Screase3D/Voron0-AutoLoader/STL/Main Plate.stl

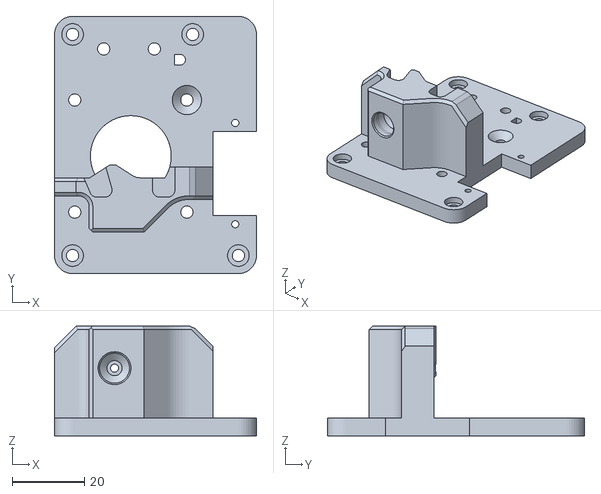
[picture p11: CAD file, 2026-10-29]
STL/Main Plate.stl
55.9 x 71.1 x 30.4
