Screase3D/Voron0-AutoLoader/CAD/V0_Backplate_Filamentloader_Inlet_Middle.step

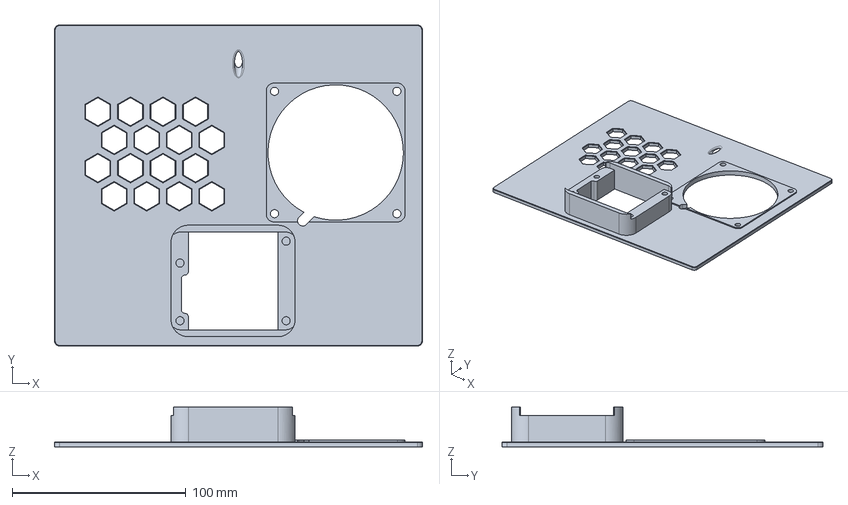
[picture p12: CAD file, 2026-10-31]
CAD/V0_Backplate_Filamentloader_Inlet_Middle.step
212.0 x 185.0 x 23.0 mm
