Screase3D/Voron0-AutoLoader/STL/Bearing Horn Adapter.stl

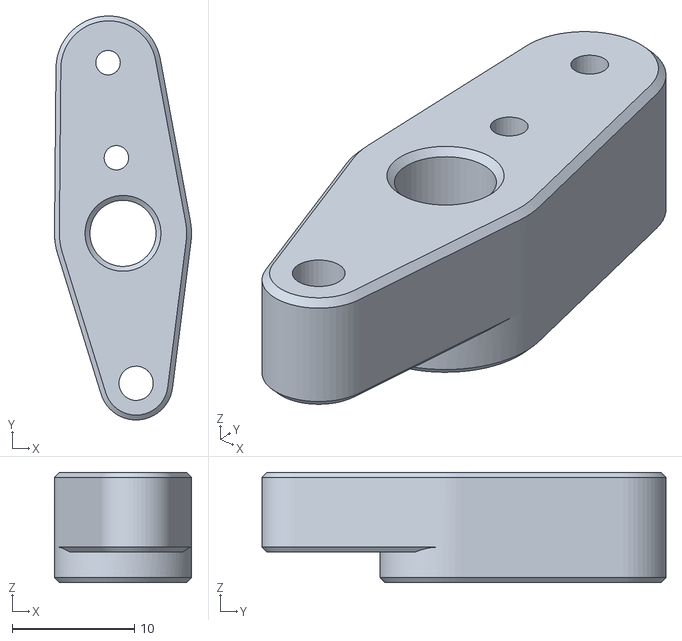
[picture p13: CAD file, 2026-10-29]
STL/Bearing Horn Adapter.stl
11.2 x 33.0 x 9.00
