Screase3D/Voron0-AutoLoader/CAD/Filament Feeder.step

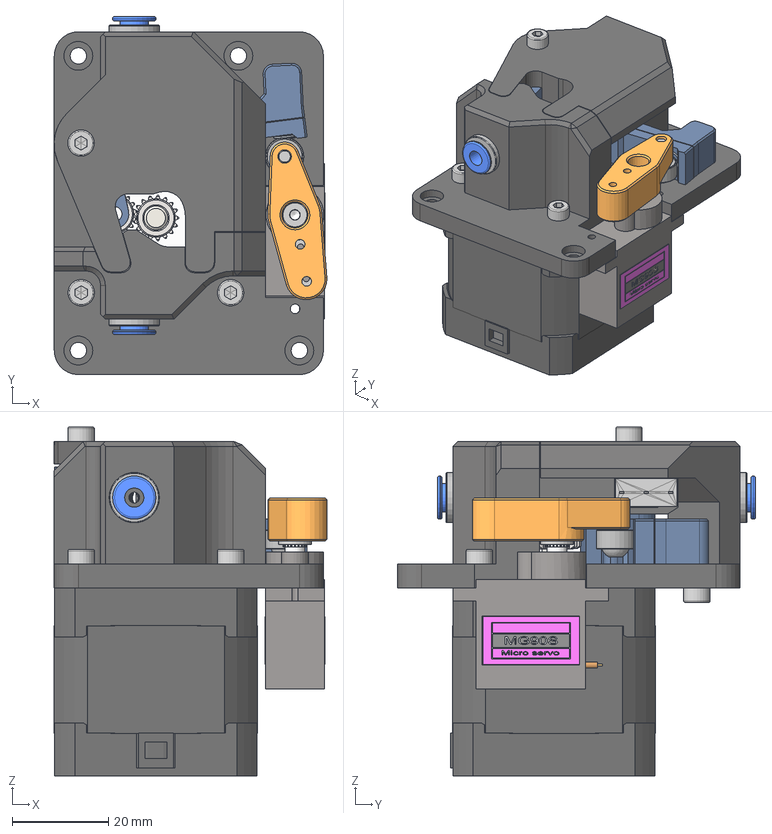
[picture p14: CAD file, 2026-10-29]
CAD/Filament Feeder.step
56.6 x 74.3 x 72.4 mm
Main Plate
Bowden In Bearing
Lever Spring V3
Lever Spring Flap V3
Servo Horn
Bearing Horn Adapter
0.4x5x15L10
ECAS04 v1
ECAS04 v1 (1)
BMG Gear Idler
BMG Gear Stepper
axe
base001
etiquette
Tube
Cylindre
Tube001
Tube002
etiquette001
Cylindre001
Cylindre002
Omron-D2F-5
693ZZ Outer Ring x 3
693ZZ Inner Ring x 3
693ZZ Shield1 x 3
693ZZ Ball x 27
693ZZ Shield2 x 3
693ZZ Outer Ring_1
693ZZ Inner Ring_1
693ZZ Shield1_1
693ZZ Ball_1 x 9
693ZZ Shield2_1
DIN EN ISO 10642 - M3 x 8 Stahl 8.8 Einfach
DIN 912 - M3 x 0.5 x 5 Stahl 4.6 Einfach x 5
ISO 4762 - M3 x 30 Stahl 4.6 Einfach
ISO 4762 - M2 x 6 Stahl 4.6 Einfach
ISO 7380-1 - M3 x 10 Stahl 4.6 Einfach
