Screase3D/Voron0-AutoLoader/STL/Bowden In Bearing.stl

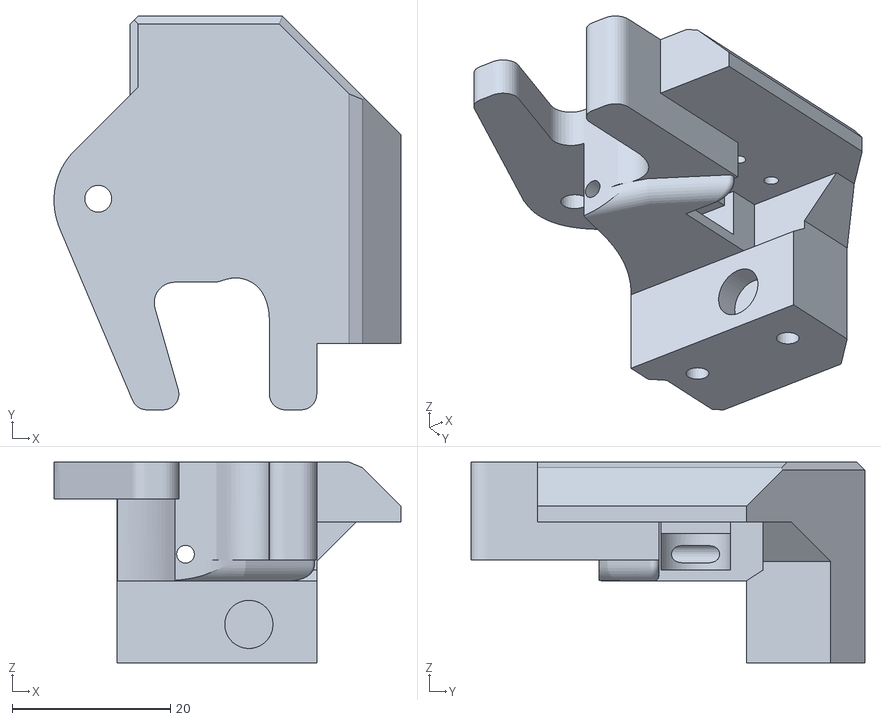
[picture p15: CAD file, 2026-10-29]
STL/Bowden In Bearing.stl
43.9 x 49.8 x 25.4
