Screase3D/Voron0-AutoLoader/STL/Lever Spring.stl

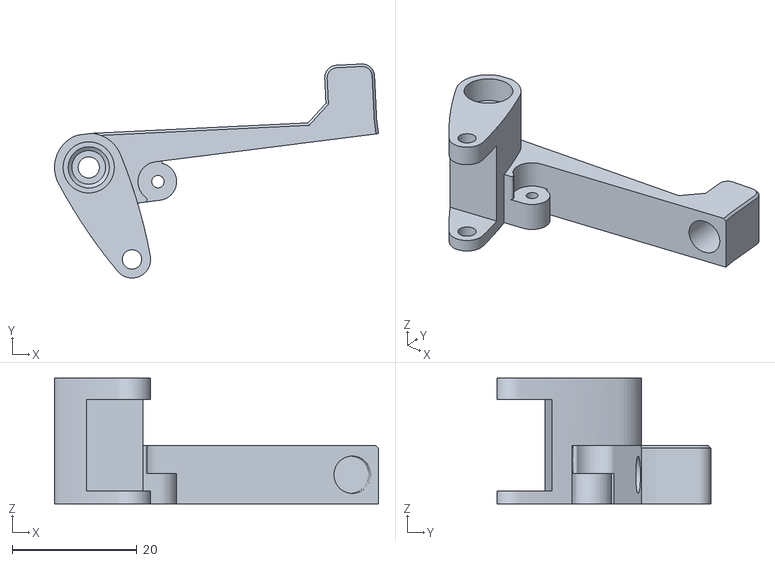
[picture p16: CAD file, 2026-10-29]
STL/Lever Spring.stl
51.9 x 34.3 x 20.1
