Screase3D/Voron0-AutoLoader/STL/Lever Spring Flap.stl

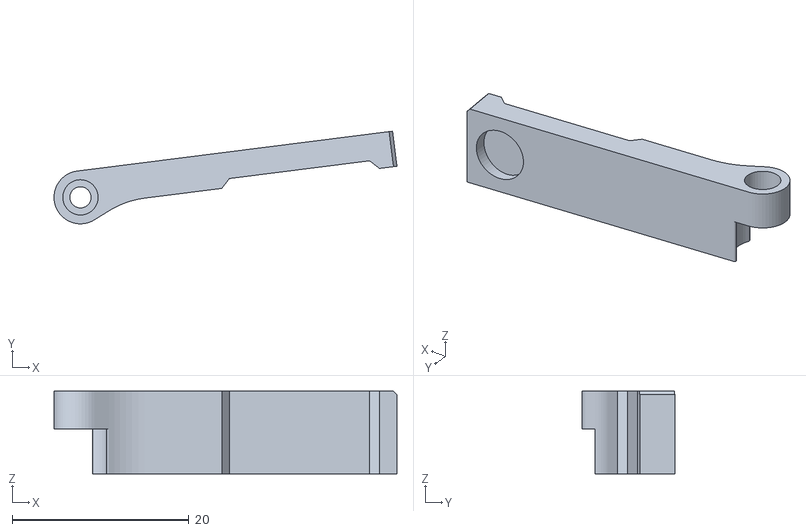
[picture p17: CAD file, 2026-10-29]
STL/Lever Spring Flap.stl
38.8 x 10.5 x 9.35
