Screase3D/Voron0-AutoLoader/(list of files, cad)

Other CAD files:
CAD/V0_Backplate_Filamentloader_Inlet_Left.step
STL/V0_Backplate_Filamentloader_Inlet_Left.stl
STL/V0_Backplate_Filamentloader_Inlet_Middle.stl
