Screase3D/Voron0-AutoLoader/docs/assembly.md

# Assembly guide

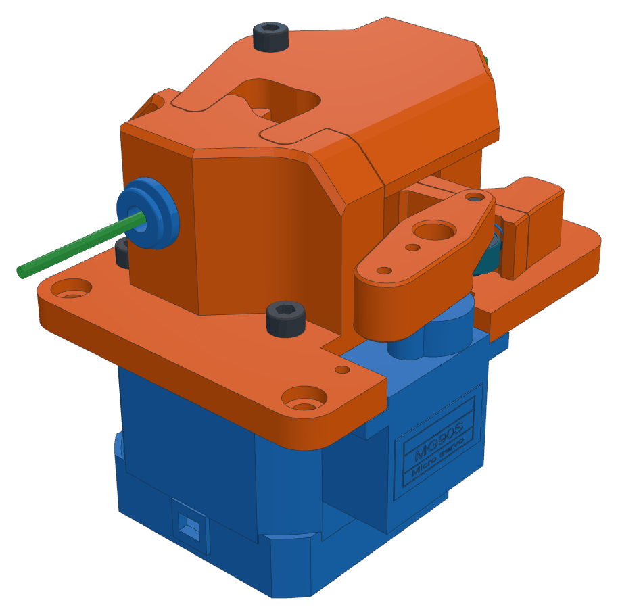
[picture p18: docs/images/assembly/overview.png]
Assembled loader
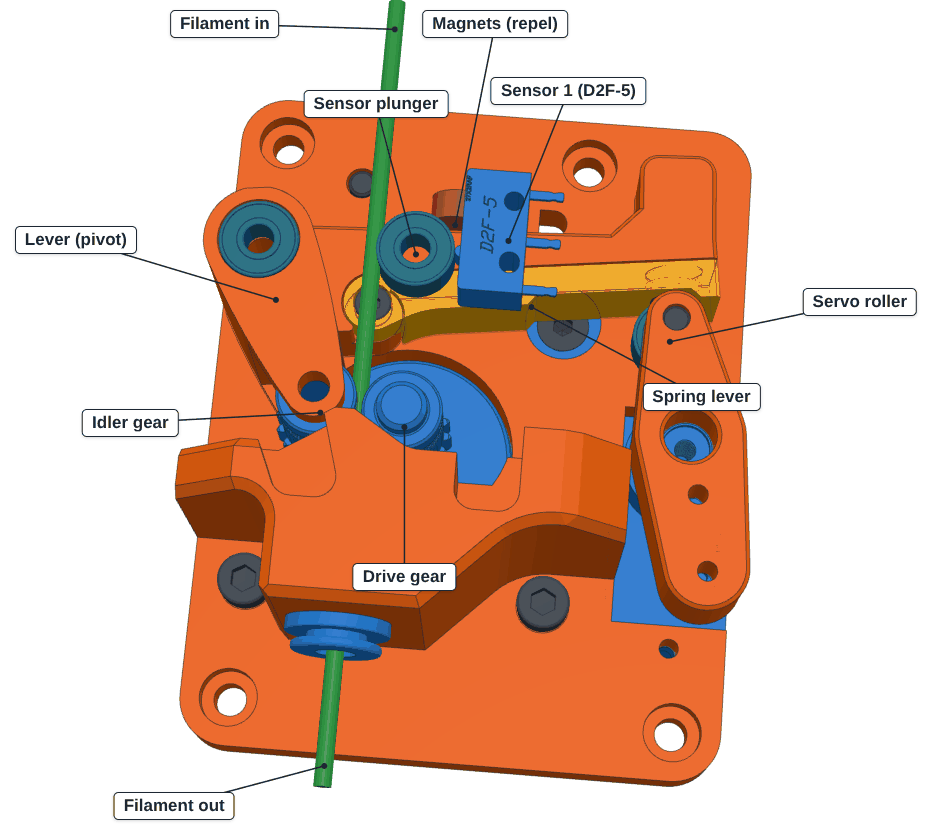
[picture p19: docs/images/assembly/function.png]
Mechanism


Orange = printed, blue = hardware, dark = screw, teal = bearing, grey = already mounted.

## Parts

**Printed** ([STL](../STL)): Main Plate, Bowden In Bearing (housing), Lever Spring (lever), Lever Spring Flap
(spring lever), Bearing Horn Adapter

| Qty | Hardware | Qty | Screws |
|---|---|---|---|
| 1 | NEMA17 stepper | 1 | M3×35 SHCS |
| 1 | MG90S servo | 2 | M3×8 SHCS |
| 1 | BMG gear set + Ø3×20 shaft | 1 | M3×8 countersunk |
| 4 | 693ZZ bearing | 2 | M3×10 SHCS |
| 1 | Omron D2F-5 | 1 | M3×10 button head |
| 2 | ECAS04 | 1 | M2×6 SHCS |
| 1 | spring 0.4×5.5×17 | 2 | M2×10 self-tapping |
| 2 | neodymium magnet 6×3 | | |
| 1 | PTFE tube 4mm OD 3mm ID | | |
| 1 | M3 Washer (for servo bearing) | | |

**Optional:** Hardware for V0.2 Backplate (see files)

| Qty | Hardware |
|---|---|
| 8 | M3x4x5mm heatset insert |
| 4 | M3x10mm SHCS |
| 4 | M3x18mm SHCS |
| 1 | Fan 80x80x10mm |

## Steps

**1.** ECAS04 into the main plate.

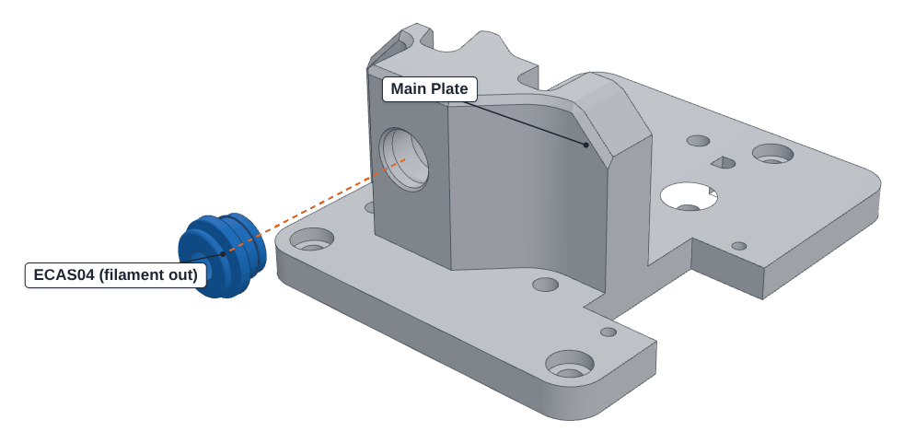
[picture p20: docs/images/assembly/01-output-coupling.png]
Step 1


**2.** Motor: 2× M3×8, 1× M3×8 countersunk. Leave the fourth hole free (pivot).

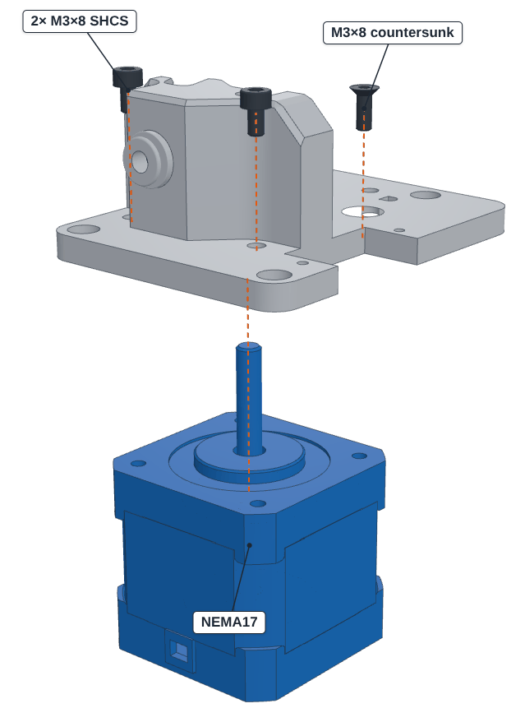
[picture p21: docs/images/assembly/02-motor.png]
Step 2


**3.** Drive gear: groove at filament height, grub screw with threadlocker.

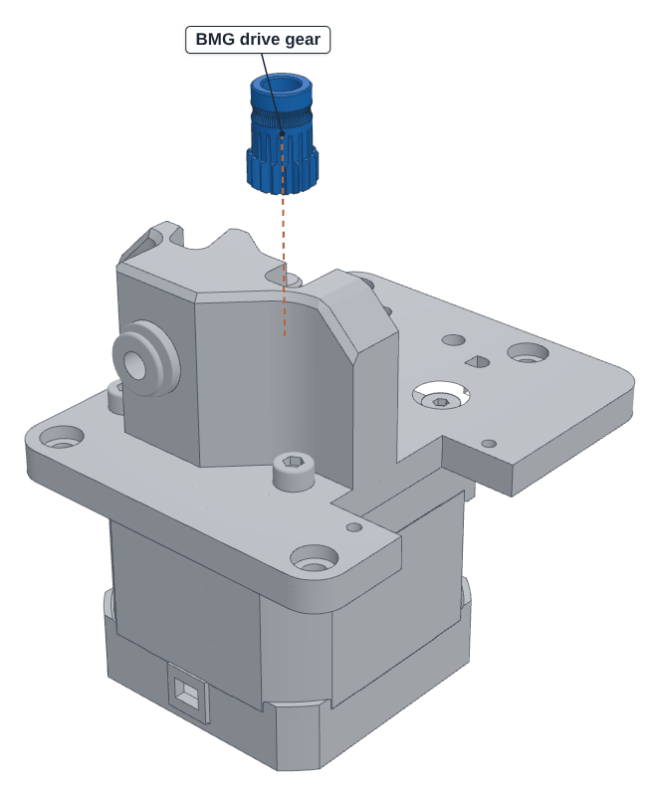
[picture p22: docs/images/assembly/03-drive-gear.png]
Step 3


**4.** Servo from below, with its two screws.

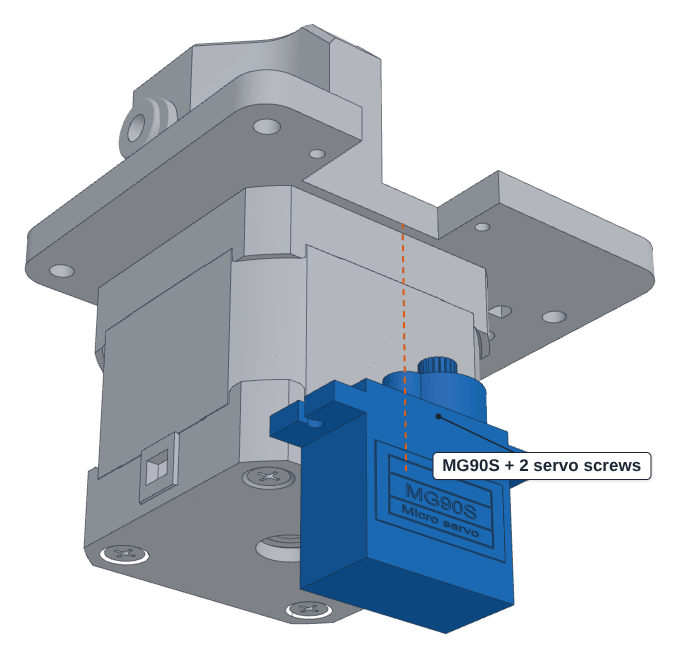
[picture p23: docs/images/assembly/04-servo.png]
Step 4


**5.** Lever: 2× 693ZZ, idler gear + shaft, spring, spring lever with M2×6 (must swing freely), magnet into the back.

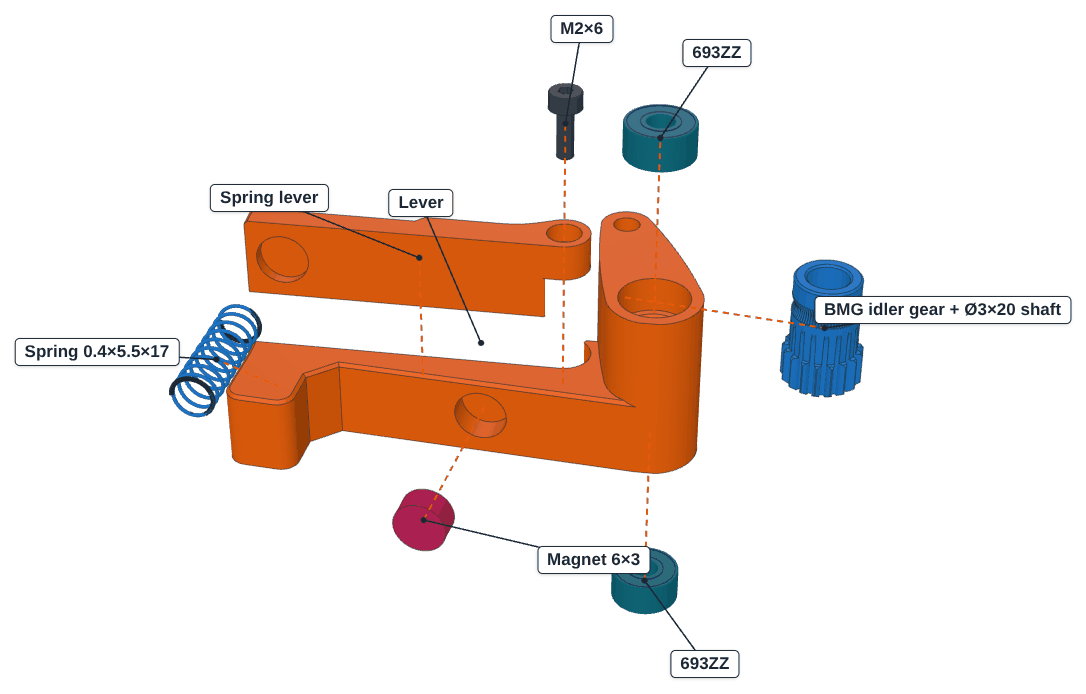
[picture p24: docs/images/assembly/05-lever.png]
Step 5


**6.** Lever onto the plate. The D-shaped hole is for the switch wires (step 8).

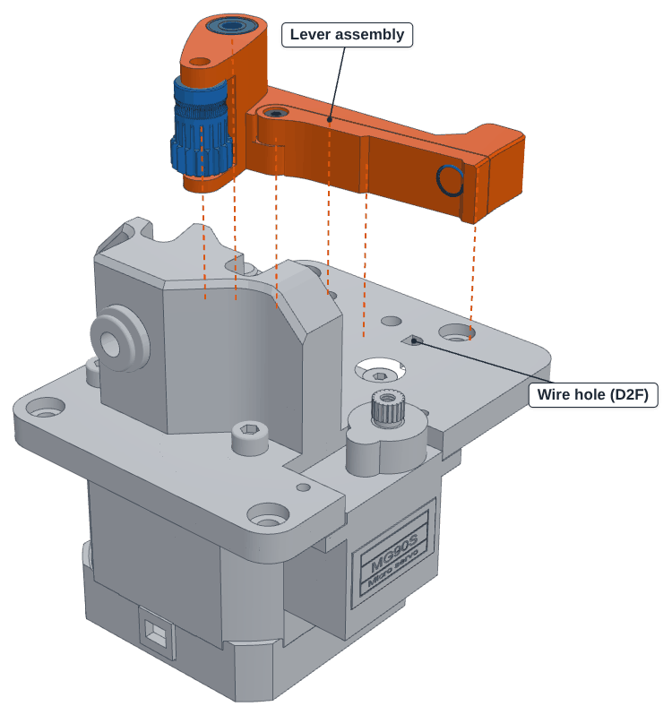
[picture p25: docs/images/assembly/06-lever-on-plate.png]
Step 6


**7.** Housing: 693ZZ into the slot, D2F-5 (wired COM + NC) with 2× M2×10 self-tapping, ECAS04, magnet.
The two magnets must **repel** each other (same pole facing): they push the lever open when the servo releases.

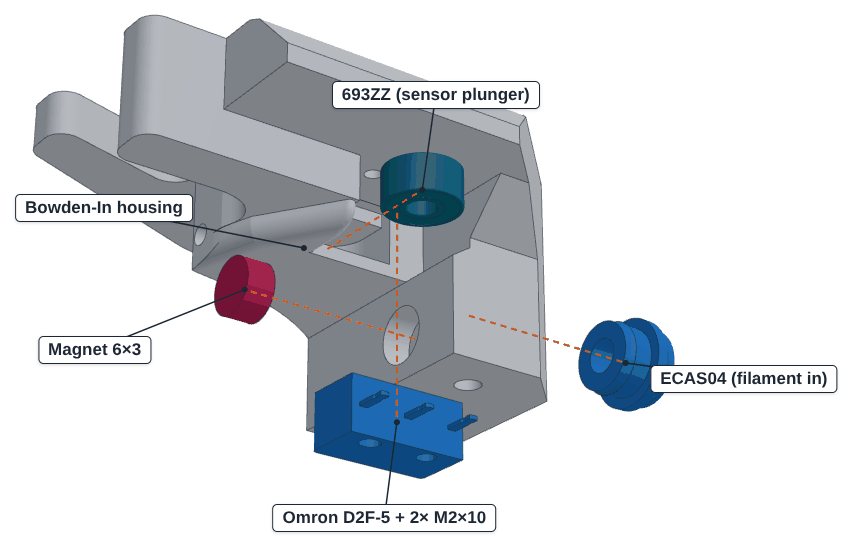
[picture p26: docs/images/assembly/07-sensor.png]
Step 7


**8.** Switch wires down through the D-shaped hole, housing on top: M3×35 through everything into the motor, 2× M3×10 from below.

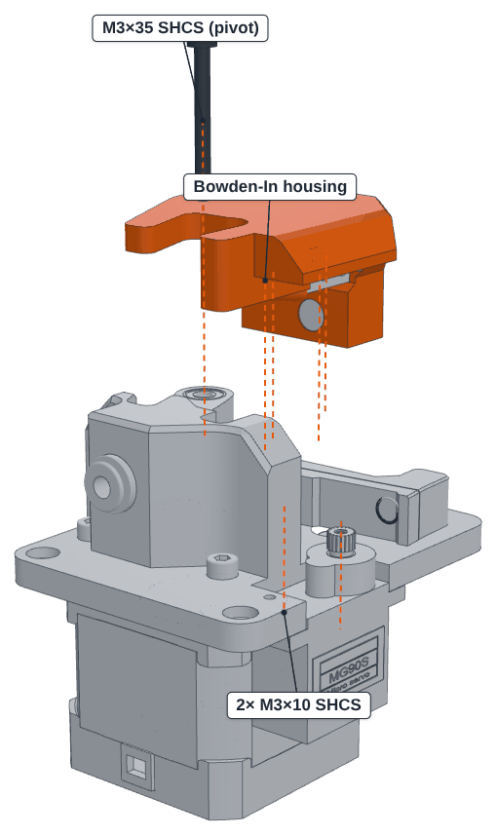
[picture p27: docs/images/assembly/08-housing.png]
Step 8


**9.** 693ZZ with M3×10 button head under the horn adapter, adapter onto the horn.

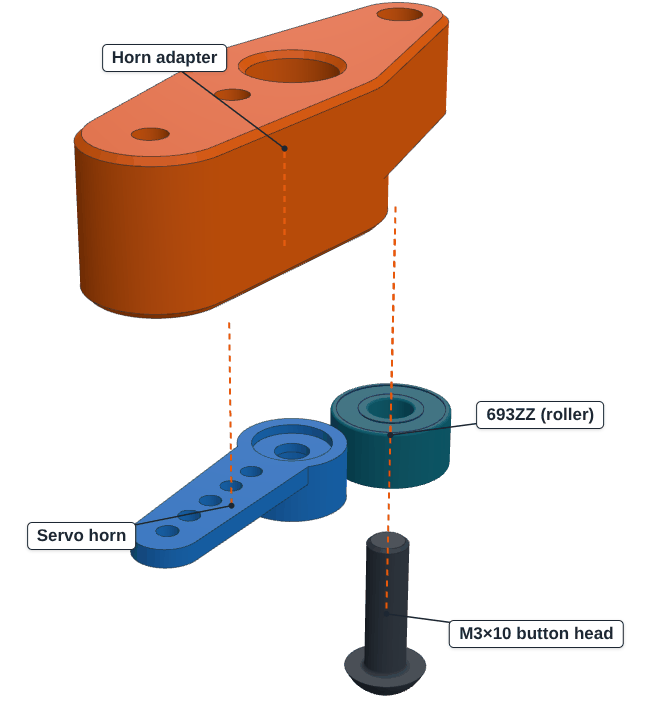
[picture p28: docs/images/assembly/09-horn-roller.png]
Step 9


**10.** `LOADER_RELEASE`, then put the horn on with the roller just clear. Angles: *Setup & calibration → Servo angles*.

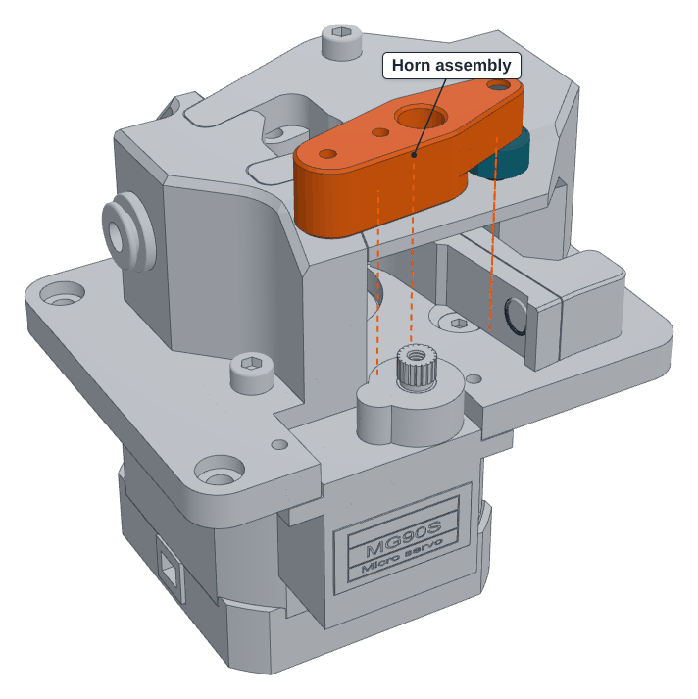
[picture p29: docs/images/assembly/10-horn-on-servo.png]
Step 10


**11.** Mount (4× M3), PTFE in, wiring: [pins](../README.md#hardware-pins), then [first setup](../README.md#first-setup).
