Screase3D/Voron0-AutoLoader/(commit log)

2026-10-25 Initial version: Filament Loader macros, installer and Mainsail UI
    Claude-Session: https://claude.ai/code/session_01VDtPnBwXqHuwKHs624Dn1u
    [filament_loader.cfg]
2026-10-25 Add filament path graphic to the web UI
    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
2026-10-25 Filament path: BMG idler arm pressed by servo horn, state 'stuck at sensor 2'
    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
2026-10-25 Rename project to Voron0-AutoLoader, English README with screenshots
    - update manager voron0-autoloader, web UI at /server/autoloader/, menu entry AutoLoader
    - KlipperScreen menu More -> AutoLoader, backups in ~/autoloader-backups
    - uninstall: also drop the blank line after the includes, skip nginx when not installed
    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
    [filament_loader.cfg]
2026-10-25 Tip forming on unload, LOAD/UNLOAD_FILAMENT wrappers, print hooks, length measuring
    - _LOADER_FORM_TIP (ramming, break-off, cooling moves) before FILAMENT_UNLOAD, LOADER_FORM_TIP for tuning
    - LOAD_FILAMENT / UNLOAD_FILAMENT call the loader (Mainsail and KlipperScreen buttons)
    - LOADER_PRINT_START (load if the toolhead is empty) / LOADER_PRINT_END (optional unload),
    inserted by the installer after M109 / before TURN_OFF_HEATERS
    - split extruder moves below max_extrude_only_distance
    - LOADER_TO_SENSOR / LOADER_EXTRUDE and a measuring helper on the page (tube_len, gear_offset, ext_to_nozzle)
    - settings schema 2: new variables are added to existing settings files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
    [filament_loader.cfg]
2026-10-25 Faster loading and a friendlier settings editor
    - full speed up to 'approach' mm before sensor 2, sensor search only on the last part
    (replaces coarse_len); defaults 150 mm/s, 30 mm/s search, accel 1500, SpreadCycle above 60 mm/s
    - abort instead of ramming into the extruder when sensor 2 triggers during the full-speed move
    - settings form generated from one table: plain labels, units, help per field, reset to default,
    inline validation, Advanced toggle, speed presets, sketch of all lengths, time estimate
    - legacy single-file migration takes over calibrated values only, not the old slow speeds
    Claude-Session: https://claude.ai/code/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
    [filament_loader.cfg]
2026-10-25 Fix sensor search: Klipper forbids recursive macros
    The step search called itself (_LOADER_FEED_TO_TOOLHEAD, _LOADER_UNLOAD_PULL), which Klipper
    aborts with 'Macro ... called recursively' after the first step. _LOADER_SEARCH now renders a
    sequence of _LOADER_SEARCH_STEP calls one after another; each reads the sensor when it runs.
    - unload search window derived from gear_offset + ext_to_nozzle - unload_ext_len
    - web UI: an operation state left over from an aborted macro no longer locks the page
    (checked against idle_timeout), shown as 'aborted' with a release button
    Claude-Session: https://claude.ai/code/session_01VDtPnBwXqHuwKHs624D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
    [filament_loader.cfg]
2026-10-25 Measuring: adjustable fast distance and maximum length for LOADER_TO_SENSOR
    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
    [filament_loader.cfg]
2026-10-25 Measuring gear_offset: servo stays clamped between steps
    - LOADER_TO_SENSOR HOLD=1 keeps the servo clamped and the stepper powered
    - LOADER_NUDGE pushes without opening the servo; -0.5 mm and a release button on the page
    - LOADER_EXTRUDE releases the loader before extruding
    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
    [filament_loader.cfg]
2026-10-25 Auto-load target, nozzle off after load/unload, fix grey overlay after dialogs
    - auto_target: auto load into the extruder (cold) or to the nozzle (hot); auto_enable as a variable
    - heater_off: M104 S0 after loading/unloading and after a failed hot operation,
    never during a print, a pause or the print hooks
    - status panel switches are saved to the settings file immediately (no restart)
    - web UI: closing a dialog left the overlay in place and blocked all clicks
    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
    [filament_loader.cfg]
2026-10-25 Remember the filament position, park option, operate/setup modes
    - Filament position (none/loader/tube/sensor2/gears/nozzle + tip in mm) is
    stored with [save_variables] and checked against both sensors at start-up;
    removal or insertion while the printer was off is detected and reported
    - Unknown tip position -> careful sensor search instead of the fast move;
    known position (e.g. parked) -> only the remaining distance is fed
    - New FILAMENT_PARK: form the tip and park park_dist mm behind sensor 2
    - print_end_action 0/1/2 (nothing / park / unload) replaces
    unload_after_print (old setting still honoured)
    - LOADER_SYNC and LOADER_SET_POS to check / correct the stored position
    - Web UI spl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
    [filament_loader.cfg]
2026-10-25 Full spools: gentler acceleration and slip check on every load
    - Every load with a known start position compares where sensor 2 triggers
    with tube_len; the deviation is shown on the page, in the history and in
    LOADER_STATUS, with a warning above slip_warn (default 10 mm)
    - Default accel 500 mm/s² (was 1500); presets 300 / 500 / 1000
    - Settings editor warns about accel above 1000 with a full spool
    - Settings schema 6: slip_warn is added by ./install.sh or by saving once
    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
    [filament_loader.cfg]
2026-10-25 Filament path graphic in Voron V0.2 style
    - Black 2020 extrusions, red accent parts, panels, CoreXY gantry with A/B
    motors and X rail, bed with textured sheet, Z lead screw, skirt with
    display, knob and feet
    - Loader: NEMA17 face with printed housing, BMG-style toothed gears, idler
    on a swing arm, MG90S with horn, couplers, micro switch with status LED,
    spool with flange spokes on its holder (turns while the loader pulls)
    - Toolhead: Sherpa Mini-style extruder, sensor block, Dragon Burner-style
    body with hotend fan (spins above 50 °C), red ducts, heatsink, heater
    block coloured by temperature, brass nozzle
    - Works in Mainsail's dark and light theme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
2026-10-26 Cold grip: loader and extruder push the last mm together
    - After the hand-over to the extruder gears, the loader (MANUAL_STEPPER
    SYNC=0) and the extruder (FORCE_MOVE, not limited by min_extrude_temp)
    move grip_len mm together, so the extruder grips even with a cold nozzle
    - Hot load extrudes ext_to_nozzle minus what was already fed while gripping;
    the ext_to_nozzle measurement on the page adds it back
    - One hand-over macro for all three load paths (_LOADER_HANDOVER)
    - Installer adds [force_move] enable_force_move: True if the config has no
    [force_move]; warns if it is set to False
    - New settings grip_len (5 mm, 0 = off) and grip_speed (5 mm/s), schema 7;
    setup checklist shows the s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
    [filament_loader.cfg]
2026-10-26 Prepare / load / load hot, unload and print start by filament position
    - FILAMENT_PREPARE: feed to sensor 2 and stop a few mm past it (not in the
    extruder, removable by hand); from cold-gripped filament it only releases
    the gears, from the nozzle it pulls out hot first
    - Load (FILAMENT_LOAD_COLD) into the extruder with cold grip, load hot to
    the nozzle; both continue from wherever the filament is
    - Unload / park only heat if the filament can be molten in the nozzle:
    loaded hot, or extruded since it was prepared / gripped (toolhead E is
    compared with the value at the last position change). Prepared or gripped
    filament is pulled back cold (loader + FORCE_MOVE together); unknown pla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
    [filament_loader.cfg]
2026-10-26 Hand-over with turning extruder, precise sensor search, UI review
    Hand-over to the extruder
    - The loader alone only pushes until the tip is 4 mm before the extruder
    gears; from there loader and extruder move together (FORCE_MOVE), so the
    gears already turn when the tip arrives instead of the tip being pushed
    against standing gears. grip_len is added on top
    - Without [force_move] the extruder motor is switched off during the
    hand-over so its gears can turn freely
    - Cold pull-out only moves the extruder when the tip is really in its gears
    Sensor search
    - Coarse search in 5 mm steps, then back a little and fine search in
    step_mm steps: the tip is never more than step_mm past sensor 2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
    [filament_loader.cfg]
2026-10-26 Generous tolerances: hand-over from sensor 2, robust fine search
    - Loader and extruder move together from sensor 2 on, so the extruder gears
    turn long before the tip arrives, independent of how exact gear_offset is
    - Fine search: after the coarse search the loader backs off until sensor 2
    is really free (filament snakes in the 3 mm PTFE bore) before searching
    again; larger window
    - Prepared filament stops only ~2.5 mm past sensor 2; the cold pull-out
    goes back to that point, well clear of the extruder gears
    - Simulated with up to 9 mm slack on direction changes: positions stay
    within the search step
    - README: tolerances section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
    [filament_loader.cfg]
2026-10-26 Measuring: recover when the fast distance was too large
    If sensor 2 is already reached during the fast move of a tube_len
    measurement, the loader now searches backwards in coarse steps until the
    sensor is free and then forwards in fine steps, so the measured value is
    still correct (before, the fine search could time out).
    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
    [filament_loader.cfg]
2026-10-26 Errors: show what failed and where, retry from the page
    - Every operation records its command and current step (fast move, search
    for sensor 2, hand-over, heating, tip forming, retract, pull back, ...);
    failures carry an error code and the step they happened in
    - Page shows an error card: what happened, during which step, likely
    causes for that error, where filament and servo are now, and buttons
    Retry, Retry carefully (sensor search step by step along the whole tube),
    Retry hot (unload/park with heating), check against sensors, OK
    - If Klipper itself aborts an operation (e.g. heater error), the last
    Klipper error message and the step are shown
    - New macros LOADER_ACK and LOADER_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
    [filament_loader.cfg]
2026-10-26 Reset button, guards against accidental macro runs
    Reset
    - LOADER_RESET CONFIRM=1: servo released, loader and extruder motor off,
    errors cleared, stored position forgotten and set from the sensors (the
    next load searches sensor 2 carefully) - for pulling filament out by hand,
    e.g. after a clog. On the control panel, in the error card, under Manual
    & test and in the KlipperScreen menu, always with a confirmation
    Accidental triggers (Mainsail / KlipperScreen macro lists)
    - LOADER_MOVE needs DIST= and refuses moves that could reach sensor 2 or
    the extruder (FORCE=1 overrides; the page asks before forcing)
    - Bench test refuses on a loaded printer; LOADER_TO_SENSOR needs COARSE=,
    LOA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
    [filament_loader.cfg]
2026-10-26 Fix: Klipper failed to start (Jinja comment in FILAMENT_UNLOAD)
    Klipper strips everything from '#' on as a comment, even inside a
    gcode template, so '{# ... #}' left a lone '{' and the template did
    not load. Use a real (unused) reference to printer.extruder.can_extrude
    instead, which also lets Mainsail enable its buttons with a cold nozzle.
    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
    [filament_loader.cfg]
2026-10-26 Never push into stationary extruder gears; one-click [force_move]
    Without [force_move] the hand-over used to push the filament with the
    extruder motor switched off. Now the extruder always turns along:
    - Load (cold) needs [force_move] and is refused otherwise (before
    anything moves), with a clear error.
    - Load hot without [force_move] waits at sensor 2 until the nozzle is
    hot and turns the extruder with G1 E in parallel to the loader.
    - Auto load with target 'cold' only prepares without [force_move].
    - Page: notice with 'Enable now' (adds [force_move] to the settings
    file and restarts), error card button, Load button disabled.
    Cl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
    [filament_loader.cfg]
2026-10-26 Page: detect a missing [force_move] correctly
    Klipper always loads its force_move module, so configfile.settings
    reports enable_force_move: False even when no [force_move] section
    exists. The page took that for a deliberately disabled section and hid
    the 'Enable now' button. Now the raw config decides whether the section
    exists.
    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
2026-10-26 Loader and extruder move truly at the same time (Klipper module)
    FORCE_MOVE flushes all pending motion first, so a loader move started
    with MANUAL_STEPPER SYNC=0 always finished before the extruder started -
    the motors ran one after the other and the filament jammed.
    New Klipper module autoloader_sync (klipper/autoloader_sync.py, linked
    into klippy/extras by the installer, section [autoloader_sync]) adds
    LOADER_DUAL_MOVE: both steppers get the same move on one shared trapq,
    via force_move.manual_move with a stepper group (works cold, no
    [force_move] needed; checked against Klipper v0.11 - master).
    All moves with the filament in loader and extruder use it: hand-over,
    pulling out cold, and p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
    [filament_loader.cfg]
2026-10-26 Control: the five buttons as targets along the filament path
    Loader - tube - sensor 2 - extruder - nozzle as stations on a track that
    fills up to where the filament is (dashed when the position is a guess,
    animated while moving). Under each station its action, with a badge:
    'filament here', 'cold', 'heats - 220 C' (only where it really heats,
    same rule as the macros) or 'running'. Tooltips explain each target or
    why it is not available. Vertical layout on phones. README screenshots.
    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
2026-10-29 Assembly guide rendered from the CAD model
    docs/assembly.md: how it works, parts list (printed, hardware, screws
    with the lengths that actually reach the thread), 11 steps with
    pictures rendered from the STEP assembly (new parts coloured, mounted
    parts grey, dashed assembly paths). Linked from the README.
    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
2026-10-29 Assembly guide: much shorter text
    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
2026-10-29 CAD and STL file upload
    [Bearing Horn Adapter.stl, Bowden In Bearing.stl, Filament Feeder.step, Lever Spring Flap.stl, Lever Spring.stl, Main Plate.stl]
2026-10-29 Print end: unload only after PRINT_END has finished
    LOADER_PRINT_END ran in the middle of PRINT_END, so the toolhead stayed
    above the part while heating and forming the tip, and filament dripped
    onto it. Now it only notes the action and temperature and a delayed
    gcode parks/unloads once PRINT_END is done (toolhead parked, bed down),
    reheating if needed and restoring the heater target afterwards.
    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
    [filament_loader.cfg]
2026-10-29 Assembly picture upload
2026-10-30 Assembly guide: magnets and switch wire hole
    - 2x 6x3 mm neodymium magnets (lever back + Bowden-In housing, repelling)
    - D-shaped hole in the main plate for the D2F-5 wires
    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
2026-10-30 Tip forming: cooling moves no longer dip below the cooling zone
    The cooling moves went from tip_cool_pos down by tip_cool_len (35 -> 25 mm
    above the nozzle with the defaults), i.e. back towards the heater block,
    where the tip softened again and got fat. tip_cool_pos is now the middle
    of the cooling zone (as described): the tip rests at pos + len/2 and the
    moves cover pos +- len/2 (defaults: 30..40 mm = Happy Hare's Dragon HF values).
    - tip_temp is now waited for before the cooling moves and restored afterwards
    - new: tip_cool_pause (let the tip harden), skinnydip (tip_dip_pos/_in/_out)
    - page: new fields, validation, time estimate, corrected tuning hints
    - settings schema 8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
    [filament_loader.cfg]
2026-10-31 Print start: stop the load a few mm before the nozzle
    Loading to the nozzle without purge ended exactly where filament comes
    out (that is how ext_to_nozzle is measured), so the print start pushed
    leftovers of the previous filament out and the pressurised nozzle oozed
    while the toolhead travelled to the purge line.
    New setting print_start_short (default 5 mm): LOADER_PRINT_START loads
    only that far before the nozzle, the purge line feeds the rest (KAMP:
    set tip_distance to the same value). Manual loads with purge unchanged.
    FILAMENT_LOAD takes SHORT= (only used without purge). Settings schema 9.
    Claude-Session: https://claude.ai/code/s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
    [filament_loader.cfg]
2026-10-31 Upload V0 Backplate files
    two versions available - PTFE inlet left and middle
    [V0_Backplate_Filamentloader_Inlet_Left.step, V0_Backplate_Filamentloader_Inlet_Left.stl, V0_Backplate_Filamentloader_Inlet_Middle.step, V0_Backplate_Filamentloader_Inlet_Middle.stl]
2026-11-02 Uninstall: remove the module link even after the repo moved; docs cleanup
    - uninstall removes any autoloader_sync.py symlink in klippy/extras (also a
    dangling one after moving/deleting the repo) and its compiled .pyc files
    - README: what uninstall does, delete the folder afterwards
    - assembly guide: fix link to the renamed 'Hardware Pins' section, printed
    part names as in STL/, spring 0.4x5.5x17 in the step 5 picture
    - THIRD_PARTY_NOTICES: CAD/STL are now included
    - remove four unused old screenshots, refresh the settings screenshots
    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
    [installer.py]
